suhani-sharma/Autonomous_Maze_solving_bot/Meshmerize_MM-222116/Photographs_MM-222116/fullmechassembled.jpg

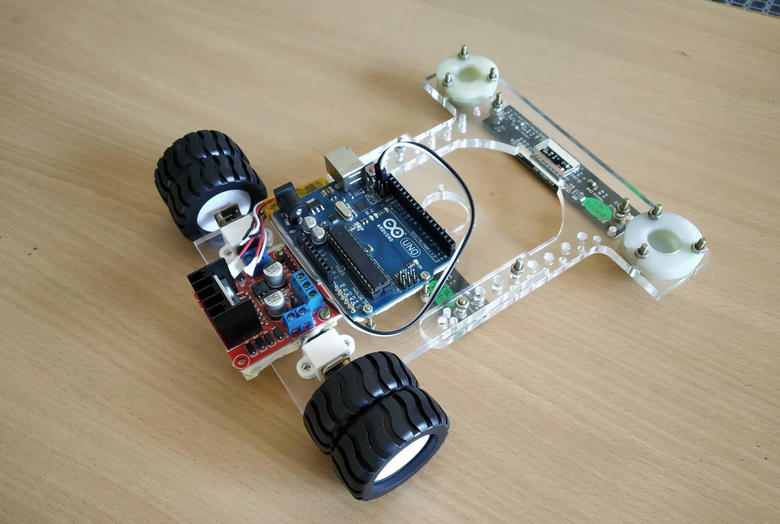
Meshmerize_MM-222116/Photographs_MM-222116/fullmechassembled.jpg
