suhani-sharma/Autonomous_Maze_solving_bot/circuit.png

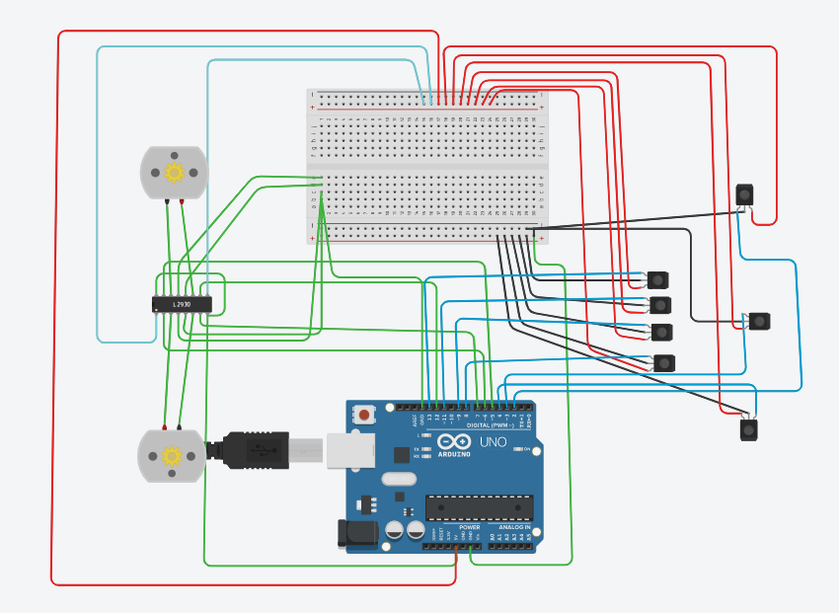
circuit.png
